mysensors/SensebenderGW/Enclosure/NRF24 NonPA enclosure print 2.jpg

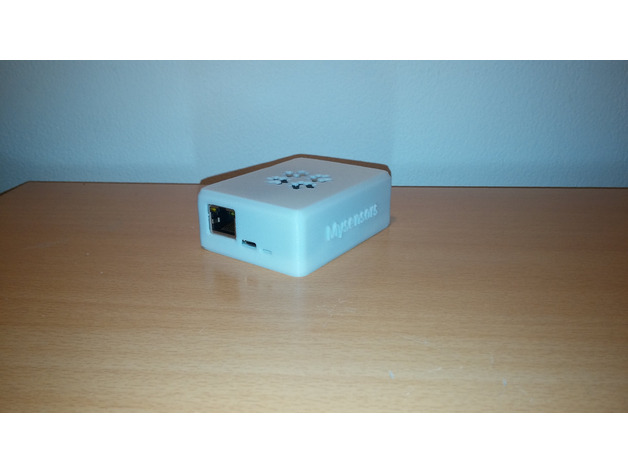
Enclosure/NRF24 NonPA enclosure print 2.jpg
