mysensors/SensebenderGW/Enclosure/NRF24 NonPA enclosure print 1.jpg

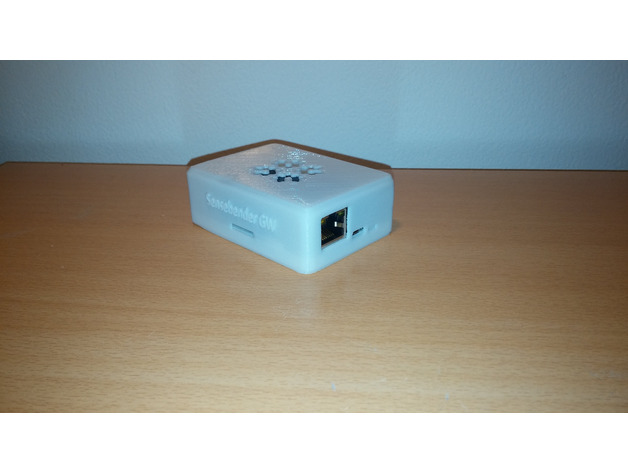
Enclosure/NRF24 NonPA enclosure print 1.jpg
