mysensors/SensebenderGW/Enclosure/3D preview rfm69 1.jpg

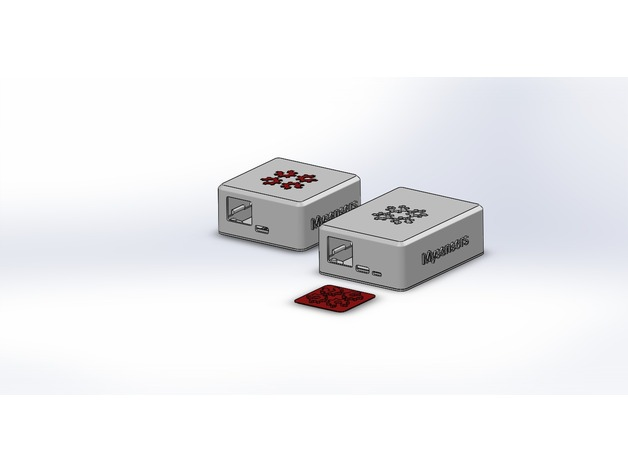
Enclosure/3D preview rfm69 1.jpg
