mysensors/SensebenderGW/Enclosure/3D preview rfm69 2.jpg

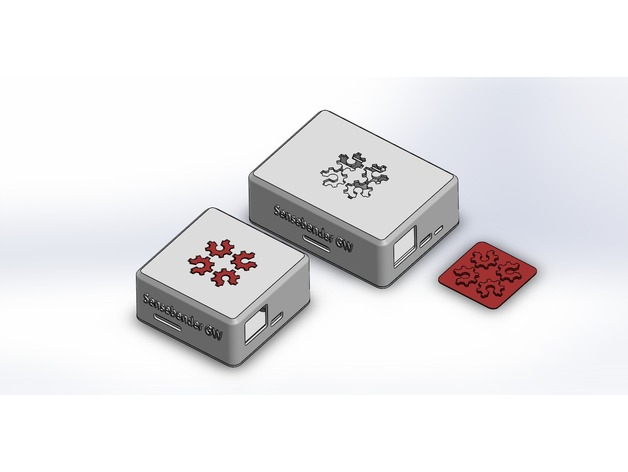
Enclosure/3D preview rfm69 2.jpg
