mysensors/SensebenderGW/Enclosure/NRF24 NonPA enclosure plate.jpg

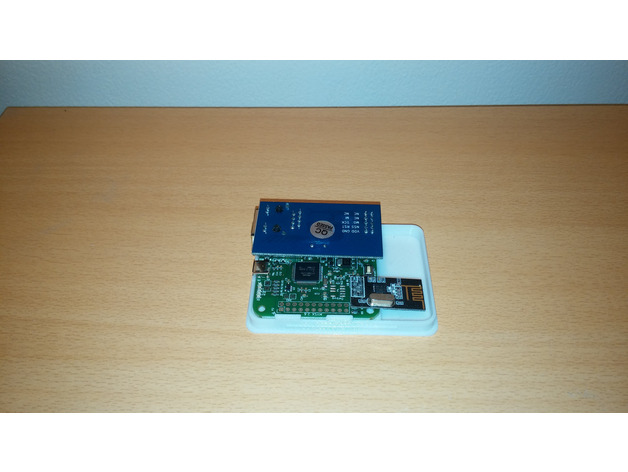
Enclosure/NRF24 NonPA enclosure plate.jpg
