mysensors/SensebenderGW/Enclosure/RFM69 enclosure plate.jpg

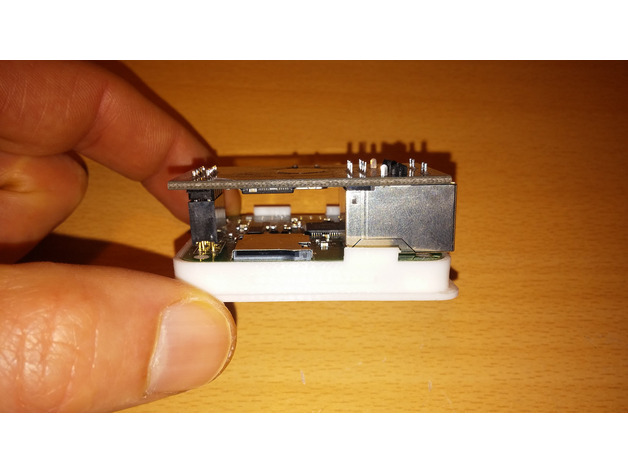
Enclosure/RFM69 enclosure plate.jpg
