mysensors/SensebenderGW/MysensorsGW.jpg

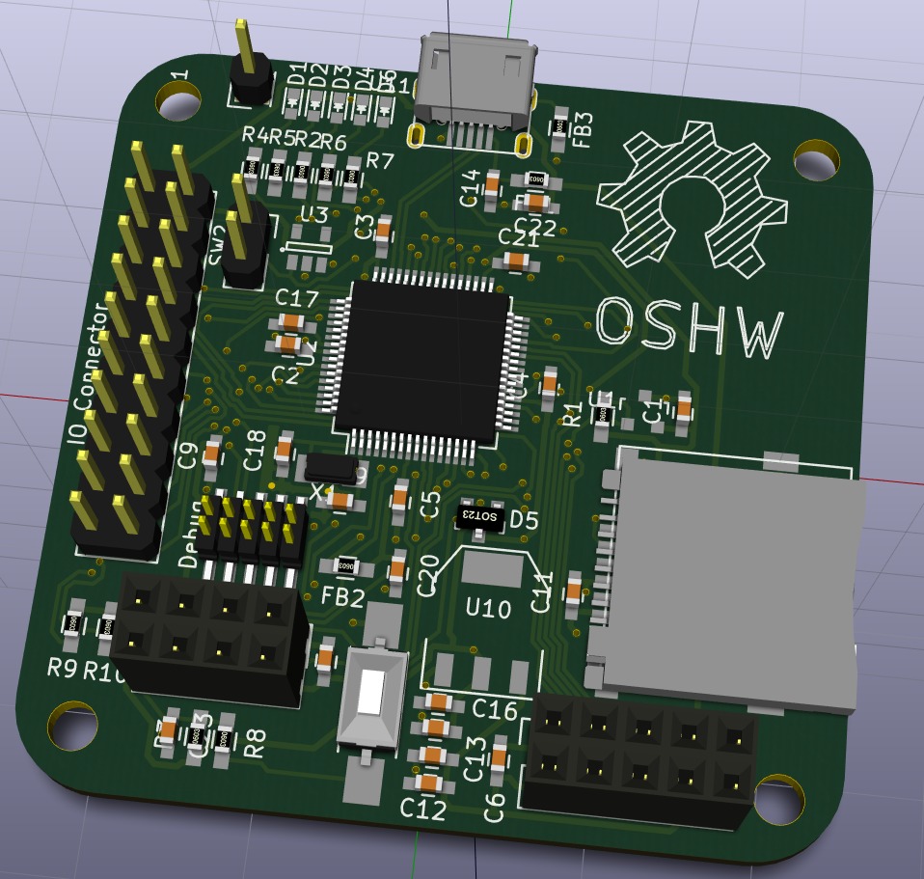
MysensorsGW.jpg
