mysensors/SensebenderGW/Enclosure/SBD_GW_LID_PA.STL

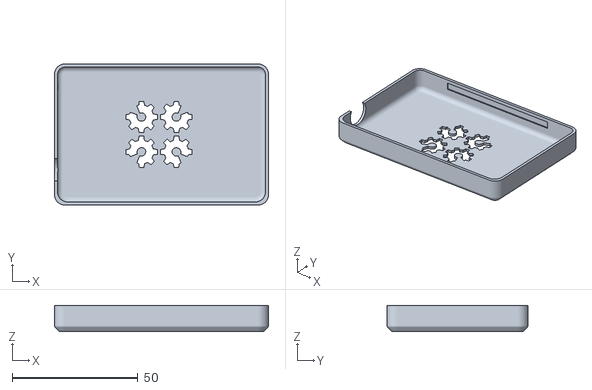
[picture p8: CAD file, 2017-03-17]
Enclosure/SBD_GW_LID_PA.STL
85.0 x 56.0 x 10.4
