mysensors/SensebenderGW/Enclosure/SBD_GW_BOTTOM_PA.STL

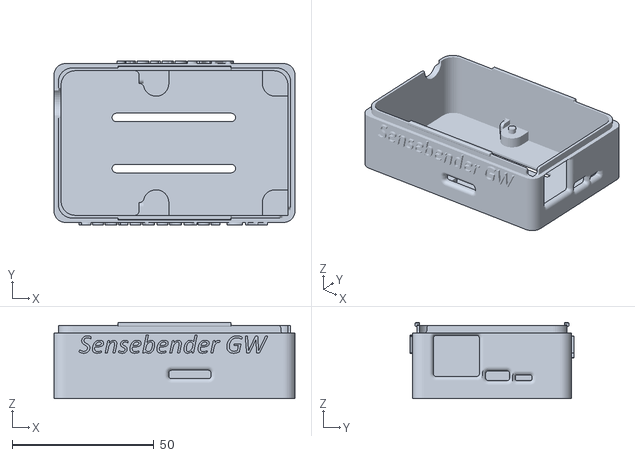
[picture p9: CAD file, 2017-03-17]
Enclosure/SBD_GW_BOTTOM_PA.STL
85.0 x 58.0 x 26.9
