mysensors/SensebenderGW/Enclosure/SBD_GW_BOTTOM_RFM69_only.STL

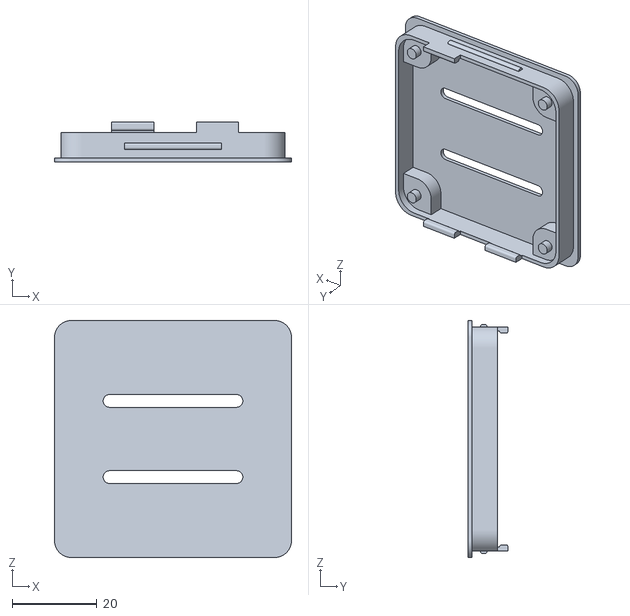
[picture p10: CAD file, 2017-02-04]
Enclosure/SBD_GW_BOTTOM_RFM69_only.STL
56.0 x 9.50 x 56.0
