mysensors/SensebenderGW/Enclosure/SBD_GW_LID_RFM69_only_with_leds_slot.STL

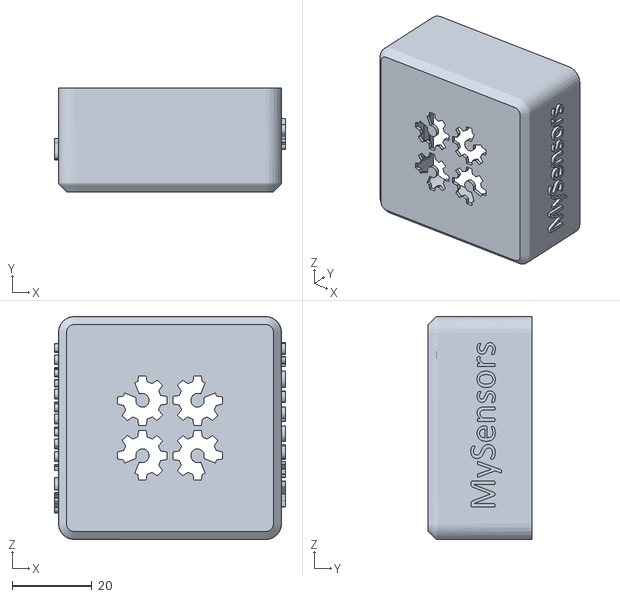
[picture p11: CAD file, 2017-02-04]
Enclosure/SBD_GW_LID_RFM69_only_with_leds_slot.STL
58.0 x 26.0 x 56.0
