mysensors/SensebenderGW/Enclosure/SBD_GW_LID_NRF24_NonPA_with_leds_slot.STL

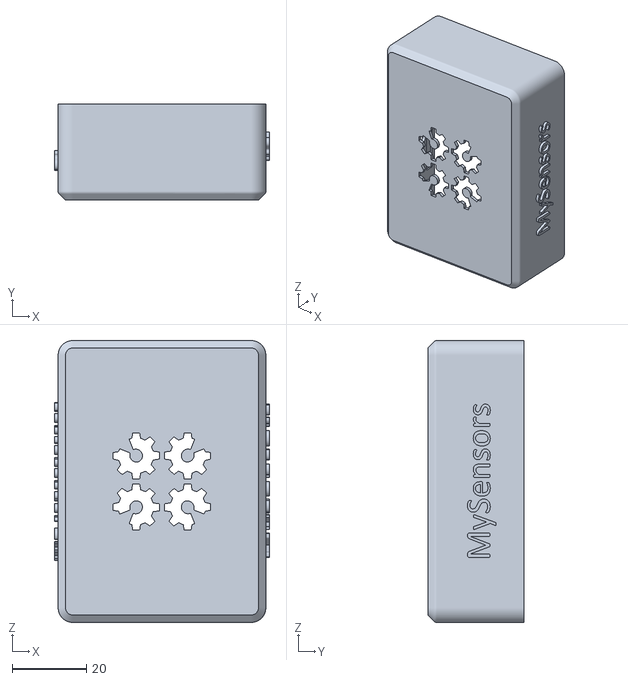
[picture p12: CAD file, 2017-02-04]
Enclosure/SBD_GW_LID_NRF24_NonPA_with_leds_slot.STL
58.0 x 26.0 x 76.0
