mysensors/SensebenderGW/Enclosure/SBD_GW_BOTTOM_NRF24_nonPA.STL

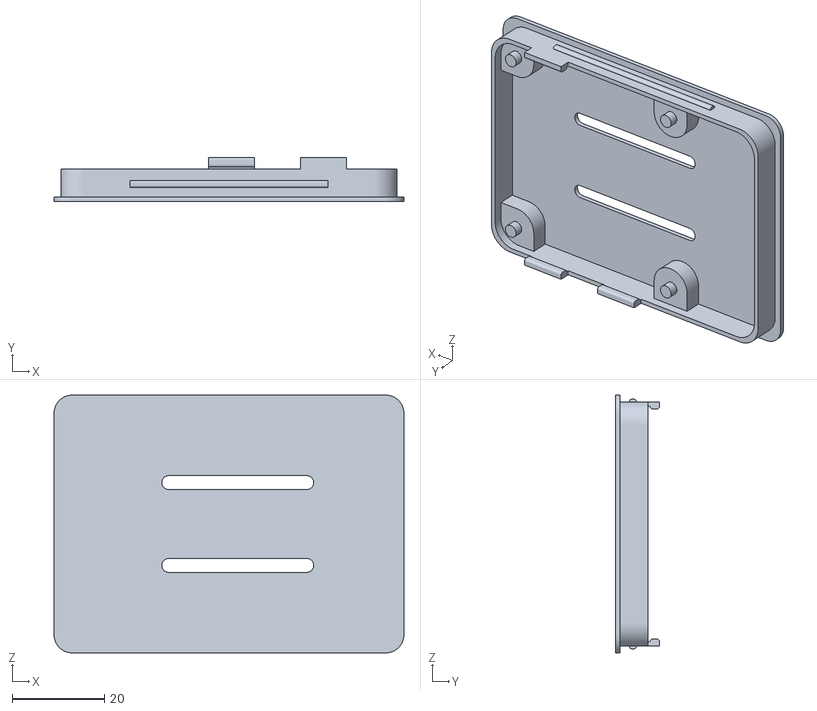
[picture p13: CAD file, 2017-02-04]
Enclosure/SBD_GW_BOTTOM_NRF24_nonPA.STL
76.0 x 9.50 x 56.0
