mysensors/SensebenderGW/Enclosure/Mini_logo_plate.STL

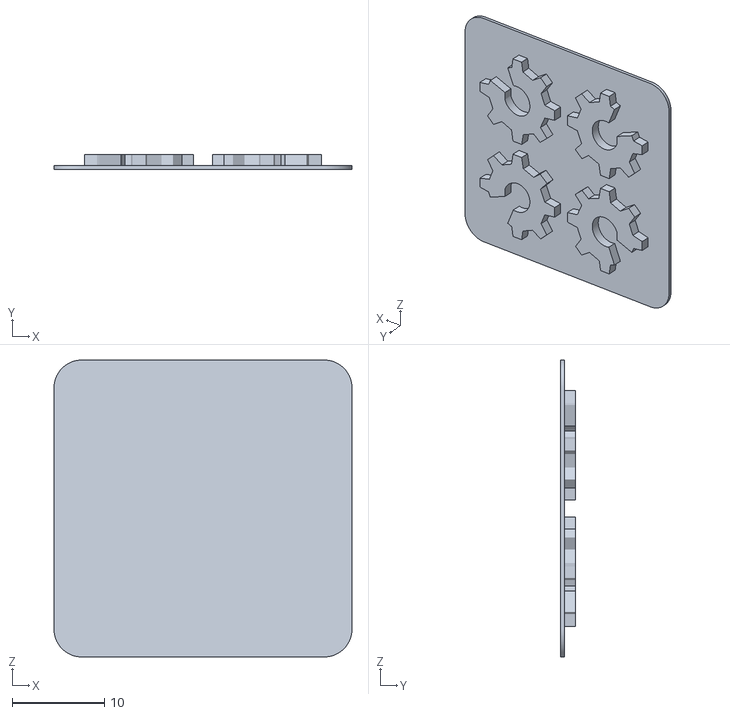
[picture p14: CAD file, 2017-02-04]
Enclosure/Mini_logo_plate.STL
32.3 x 1.60 x 32.2
