mysensors/SensebenderGW/(list of files, cad)

Other CAD files:
Enclosure/SBD_GW_BOTTOM_PA_NO_ETH.STL
Enclosure/SBD_GW_LID_RFM69_only_no_leds_slot.STL
Enclosure/SBD_GW_LID_NRF24_NonPA_no_leds_slot.STL
