mysensors/SensebenderGW/MysensorsGW.pdf

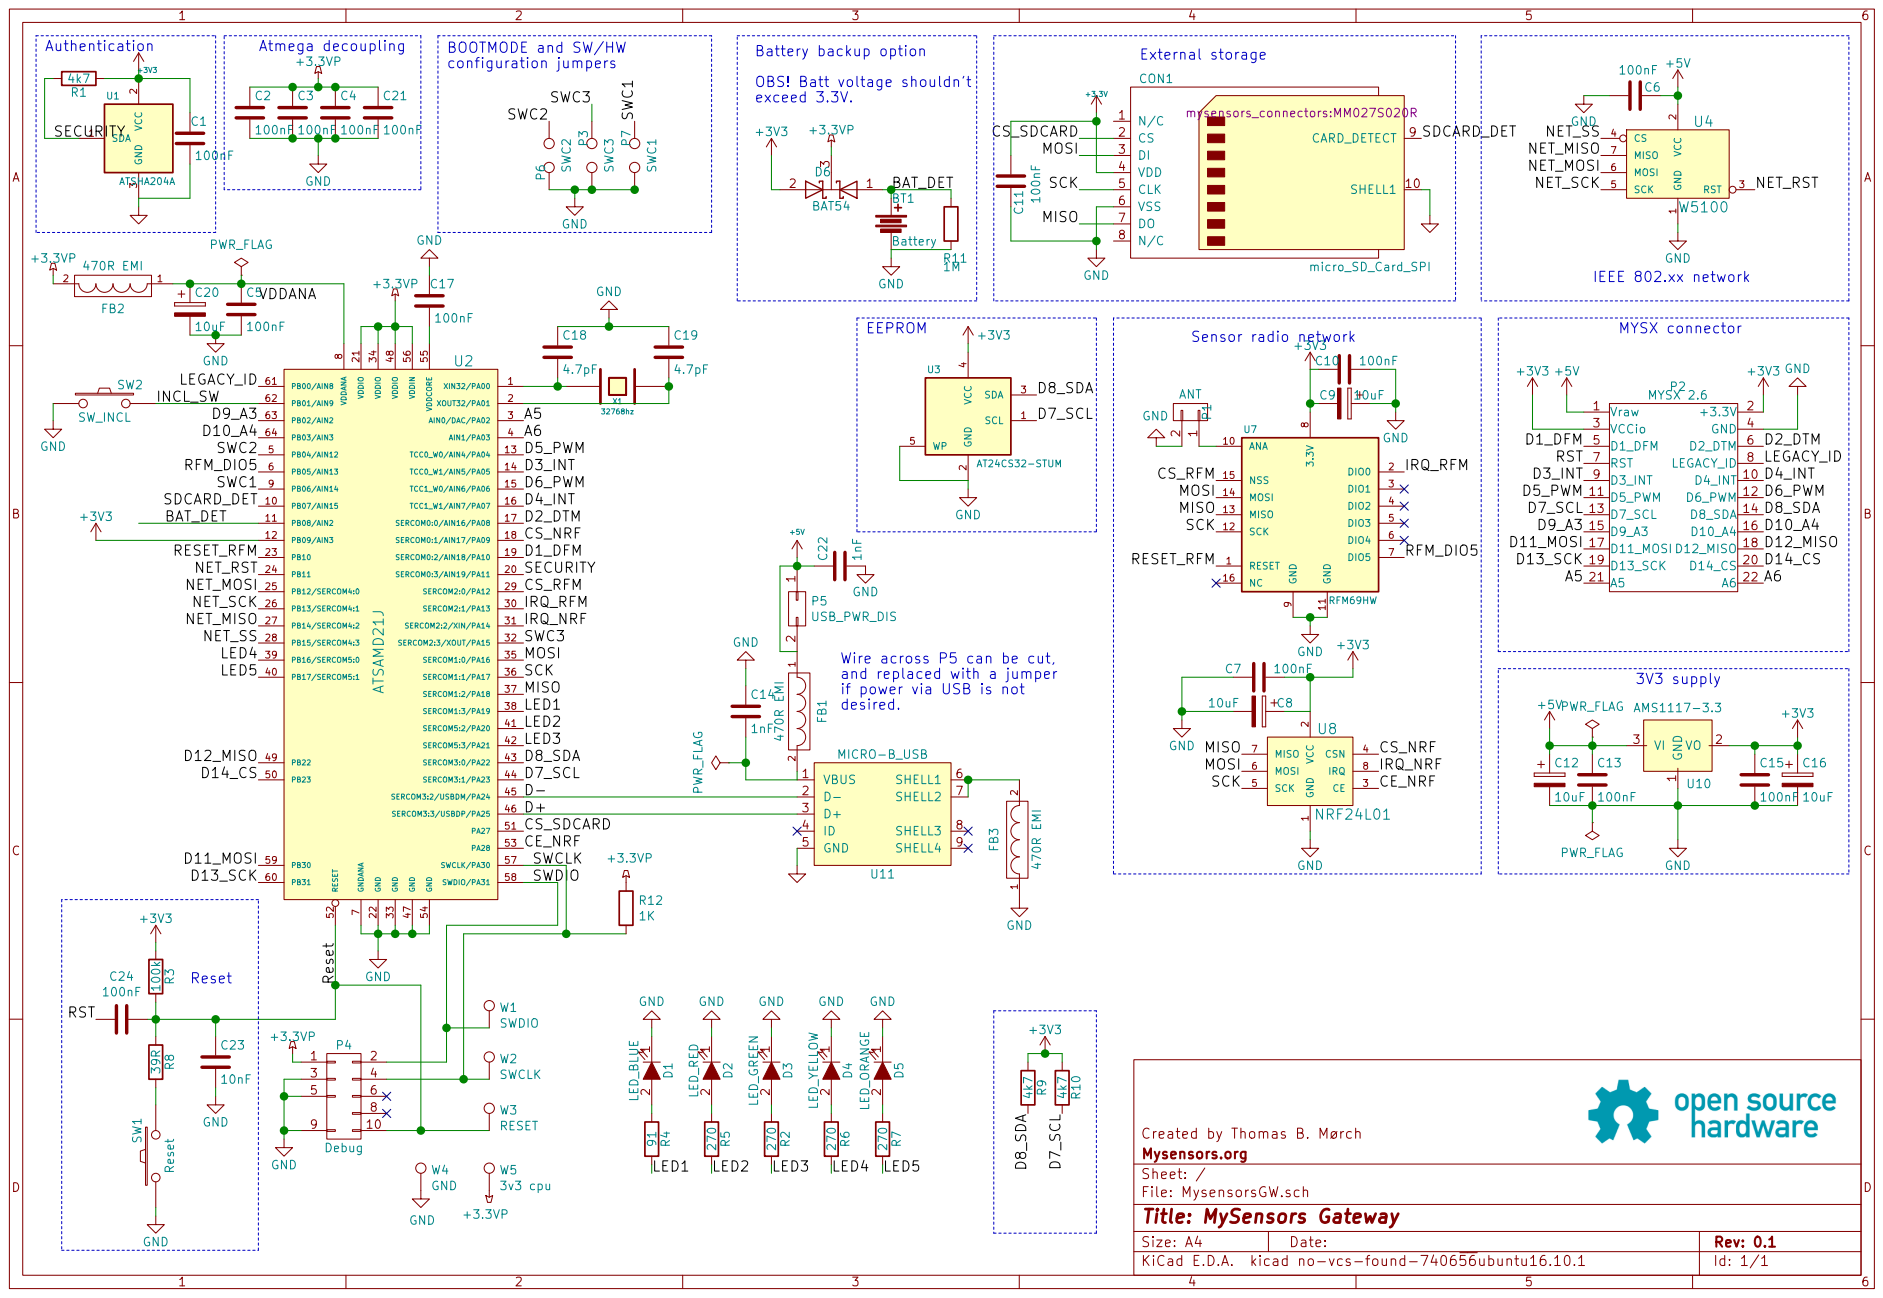
[picture p15: page 1]

3 D6 BAT54 BT1 Battery GND Battery backup option

2 RST 3 CS 4 SCK 5 MOSI 6 MISO 7 U4 W5100

IEEE 802.xx network MISO

9 ANA 10 GND 11 SCK 12 MISO 13 MOSI 14 NSS 15 NC 16 U7 RFM69HW D9_A3 D10_A4

1 2 P5 USB_PWR_DIS Wire across P5 can be cut,

and replaced with a jumper

2 CE 3 CSN 4 SCK 5 MOSI 6 MISO 7

CS_SDCARD

PB31 60 | SWDIO

File: MysensorsGW.sch Sheet: / Mysensors.org

Id: 1/1 Title: MySensors Gateway
