mysensors/SensebenderGW/(commit log)

2015-04-22 Beautified schematic a little
    [MysensorsGW.kicad_pcb, MysensorsGW.sch]
2015-04-25 Updated schematics
    [MysensorsGW.kicad_pcb, MysensorsGW.sch]
2015-05-11 Updated schematics, including w5100
    [MysensorsGW.kicad_pcb, MysensorsGW.sch, SensorRadio.sch]
2015-05-23 Added connectors for GPIO's, and other things..
    [MysensorsGW.kicad_pcb, MysensorsGW.sch, SensorRadio.sch]
2015-05-25 Cleaned up schematics, all components on one sheet of paper now
    [MysensorsGW.kicad_pcb, MysensorsGW.sch, SensorRadio.sch]
2015-05-27 Shematics cleanup
    [MysensorsGW.kicad_pcb, MysensorsGW.sch]
2015-05-27 Updated readme file, and legends on schematics
    [MysensorsGW.sch]
2015-05-27 Added BOM (csv file)
    [MysensorsGW.csv, MysensorsGW.kicad_pcb]
2015-06-01 Moving things around
    [MysensorsGW.kicad_pcb, MysensorsGW.sch]
2015-06-06 Added MAX3002E to do level conversion between 5V and 3v3 domains
    [MysensorsGW.kicad_pcb, MysensorsGW.sch]
2015-06-08 Updated schematics, exchanged one MAX3002 to a MAX3378, which is better suited for I2C bus
    [MysensorsGW.kicad_pcb, MysensorsGW.sch]
2015-06-10 Updated mouser references on components
    [MysensorsGW.csv, MysensorsGW.kicad_pcb, MysensorsGW.sch]
2015-06-20 Added 2 WS2812B rgb leds for status indicators, and filtering components on USB connector
    [MysensorsGW.csv, MysensorsGW.kicad_pcb, MysensorsGW.sch]
2015-06-21 Changed LED's to two standard led's instead of RGB (too much trouble in correct timing on the 1 wire control bus)
    Changed IO connector to a 2x11, instead of 2x14, and removed a couple of signals (there simply isn't that much space for the larger IO connector)
    [MysensorsGW.kicad_pcb, MysensorsGW.sch]
2015-06-22 Updated schematics, corrected errors / warnings in ERC
    [MysensorsGW.kicad_pcb, MysensorsGW.sch]
2015-06-22 Updated project files, to follow mysensors kicad library standard
    [MysensorsGW.sch]
2015-06-23 Updated project to mysensors_kicad standard. (see https://github.com/mysensors-kicad/part_management for more information)
    [MysensorsGW.kicad_pcb, MysensorsGW.sch]
2015-06-25 updated schematics a bit, updated PCB with 3dmockups. Added OSHW logo to schematics
    [MysensorsGW.kicad_pcb, MysensorsGW.sch]
2015-07-07 Updated schematic, swapped A2 and A3
    [MysensorsGW.sch]
2015-07-08 updating board connector, and moving pins around for the level shifters
2015-07-10 Rearrangement of MYSX connector in progress
    [MysensorsGW.kicad_pcb, MysensorsGW.sch]
2015-07-13 Changed MCU to ATSAMD21 instead of atmega1284.
    Removed level converters and FTDI chip, as it's not needed (builtin USB in the D21)
    [MysensorsGW.kicad_pcb, MysensorsGW.sch]
2015-07-13 Updated components with mouser order no. and prepared "core functionality" on a D21E variant of the atsam MCU
    [MysensorsGW.kicad_pcb, MysensorsGW.sch]
2015-07-17 Finished most of the routing on the board
    [MysensorsGW.kicad_pcb, MysensorsGW.sch]
2015-07-18 Added pullup on I2C bus
    [MysensorsGW.kicad_pcb, MysensorsGW.sch]
2015-07-18 Added gerber files
    [MysensorsGW-B_Cu.gbr, MysensorsGW-Edge_Cuts.gbr, MysensorsGW-F_Cu.gbr, MysensorsGW-F_Fab.gbr, MysensorsGW-F_Mask.gbr, MysensorsGW-F_Paste.gbr, MysensorsGW-F_SilkS.gbr, MysensorsGW-Margin.gbr]
2015-07-18 Removed ws2812b library reference from the schematics
    [MysensorsGW.kicad_pcb, MysensorsGW.sch]
2015-07-18 Added connection for ESP8266 GPIO0 (so we can put it into FW download mode
    [MysensorsGW.kicad_pcb]
2015-07-19 Added connection from GPIO2 on ESP module to port on ATSAM, added bottom layer solder mask
    [MysensorsGW-B_Cu.gbr, MysensorsGW-B_Mask.gbr, MysensorsGW-B_SilkS.gbr, MysensorsGW-Edge_Cuts.gbr, MysensorsGW-F_Cu.gbr, MysensorsGW-F_Fab.gbr, MysensorsGW-F_Mask.gbr, MysensorsGW-F_Paste.gbr]
2015-07-21 Removed FETs on outputs for LED, as it should be enough with 5mA for the LED.. (and max current is 7mA per IO pin)
    [MysensorsGW-B_Cu.gbr, MysensorsGW-B_Mask.gbr, MysensorsGW-B_SilkS.gbr, MysensorsGW-Edge_Cuts.gbr, MysensorsGW-F_Cu.gbr, MysensorsGW-F_Fab.gbr, MysensorsGW-F_Mask.gbr, MysensorsGW-F_Paste.gbr]
2015-07-21 Updated with module corrections on RFM69HW, from @fallberg
    [MysensorsGW.kicad_pcb]
2015-07-21 Added extra status LED (LED4)
    [MysensorsGW-B_Cu.gbr, MysensorsGW-B_Mask.gbr, MysensorsGW-B_SilkS.gbr, MysensorsGW-Edge_Cuts.gbr, MysensorsGW-F_Cu.gbr, MysensorsGW-F_Fab.gbr, MysensorsGW-F_Mask.gbr, MysensorsGW-F_Paste.gbr]
2015-07-24 Added extra i2c eeprom, U3, as the ATSAMD21 doesn't have an internal eeprom.
    [MysensorsGW-B_Cu.gbr, MysensorsGW-B_Mask.gbr, MysensorsGW-B_SilkS.gbr, MysensorsGW-Edge_Cuts.gbr, MysensorsGW-F_Cu.gbr, MysensorsGW-F_Fab.gbr, MysensorsGW-F_Mask.gbr, MysensorsGW-F_Paste.gbr]
2015-07-24 Updated USB connector to use right symbol in the schematics, Also added EMI filter from shield of USB cable to GND
    [MysensorsGW-B_Cu.gbr, MysensorsGW-B_Mask.gbr, MysensorsGW-B_SilkS.gbr, MysensorsGW-Edge_Cuts.gbr, MysensorsGW-F_Cu.gbr, MysensorsGW-F_Fab.gbr, MysensorsGW-F_Mask.gbr, MysensorsGW-F_Paste.gbr]
2015-07-24 Updated IO connector symbol in schematic to use MYSX1.5 connector, instead of generic
    [MysensorsGW.kicad_pcb, MysensorsGW.sch]
2015-07-24 Cleaned up schematic, DRC is now without errors
    [MysensorsGW.sch]
2015-07-25 Added jtagice3 compatible cortex M debug port to bottom layer
    [MysensorsGW-B_Cu.gbr, MysensorsGW-B_Mask.gbr, MysensorsGW-B_SilkS.gbr, MysensorsGW-Edge_Cuts.gbr, MysensorsGW-F_Cu.gbr, MysensorsGW-F_Fab.gbr, MysensorsGW-F_Mask.gbr, MysensorsGW-F_Paste.gbr]
2015-07-25 Calculated values for xtal load caps, and found mouser partnumbers
    [MysensorsGW.sch]
2015-07-25 Moved component designators around on the silkscreen layers, + Added descriptive texts here and there on the silk screen
    [MysensorsGW-B_Cu.gbr, MysensorsGW-B_Mask.gbr, MysensorsGW-B_SilkS.gbr, MysensorsGW-Edge_Cuts.gbr, MysensorsGW-F_Cu.gbr, MysensorsGW-F_Fab.gbr, MysensorsGW-F_Mask.gbr, MysensorsGW-F_Paste.gbr]
2015-07-26 Updated various components with more correct 3d shapes. Updated footprints for reset switch, and crystal, to match the chosen components from mouser
    [MysensorsGW-B_Cu.gbr, MysensorsGW-B_Mask.gbr, MysensorsGW-B_SilkS.gbr, MysensorsGW-Edge_Cuts.gbr, MysensorsGW-F_Cu.gbr, MysensorsGW-F_Fab.gbr, MysensorsGW-F_Mask.gbr, MysensorsGW-F_Paste.gbr]
2015-07-27 small updates in layout around NRF module header
    [MysensorsGW-B_Cu.gbr, MysensorsGW-B_Mask.gbr, MysensorsGW-B_SilkS.gbr, MysensorsGW-Edge_Cuts.gbr, MysensorsGW-F_Cu.gbr, MysensorsGW-F_Fab.gbr, MysensorsGW-F_Mask.gbr, MysensorsGW-F_Paste.gbr]
2015-07-28 small adjustments to pcb, removed unnescesarry files from manufacturing dir, drill files merged to one prepared manufacturing output script for creating dirtypcb gerbers
    [MysensorsGW-B_Cu.gbr, MysensorsGW-B_Mask.gbr, MysensorsGW-B_SilkS.gbr, MysensorsGW-Edge_Cuts.gbr, MysensorsGW-F_Cu.gbr, MysensorsGW-F_Fab.gbr, MysensorsGW-F_Mask.gbr, MysensorsGW-F_Paste.gbr]
2015-07-29 Cleaned up the last couple of DRC on pcb, that can be fixed (the rest is known, and intentional)
    [MysensorsGW-B_Cu.gbr, MysensorsGW-B_Mask.gbr, MysensorsGW-B_SilkS.gbr, MysensorsGW-Edge_Cuts.gbr, MysensorsGW-F_Cu.gbr, MysensorsGW-F_Fab.gbr, MysensorsGW-F_Mask.gbr, MysensorsGW-F_Paste.gbr]
2015-07-29 Final touch up before ordering
    [MysensorsGW-B_Cu.gbr, MysensorsGW-B_Mask.gbr, MysensorsGW-B_SilkS.gbr, MysensorsGW-Edge_Cuts.gbr, MysensorsGW-F_Cu.gbr, MysensorsGW-F_Fab.gbr, MysensorsGW-F_Mask.gbr, MysensorsGW-F_Paste.gbr]
2015-07-29 Added OSHW logo to silkscreen, order send
    [MysensorsGW-B_Cu.gbr, MysensorsGW-B_Mask.gbr, MysensorsGW-B_SilkS.gbr, MysensorsGW-Edge_Cuts.gbr, MysensorsGW-F_Cu.gbr, MysensorsGW-F_Fab.gbr, MysensorsGW-F_Mask.gbr, MysensorsGW-F_Paste.gbr]
2015-08-28 Swapped GND/VCC on jtagice3 connector Fixes #1
    [MysensorsGW.kicad_pcb, MysensorsGW.sch]
2015-08-30 Swapped pins around on the SPI signals. Added a couple of extra jumpers / testpoints to the backside, can be used to select special SW modes. fixes #2
    [MysensorsGW.kicad_pcb, MysensorsGW.sch]
2015-08-30 Swapped MISO/MOSI signals on esp8266 (doubles as RX/TX signals when SERCOM unit is acting as UART)
    [MysensorsGW.kicad_pcb, MysensorsGW.sch]
2015-08-31 Cleanup of the PCB, moved component refs, and texts a bit around
    [MysensorsGW-B_Cu.gbr, MysensorsGW-B_Mask.gbr, MysensorsGW-B_SilkS.gbr, MysensorsGW-Edge_Cuts.gbr, MysensorsGW-F_Cu.gbr, MysensorsGW-F_Fab.gbr, MysensorsGW-F_Mask.gbr, MysensorsGW-F_Paste.gbr]
2015-08-31 Adjusted mounting hole positions
    [MysensorsGW-B_Cu.gbr, MysensorsGW-B_Mask.gbr, MysensorsGW-B_SilkS.gbr, MysensorsGW-Edge_Cuts.gbr, MysensorsGW-F_Cu.gbr, MysensorsGW-F_Fab.gbr, MysensorsGW-F_Mask.gbr, MysensorsGW-F_Paste.gbr]
2015-08-31 Added BOM file
    [MysensorsGW.csv]
2015-09-01 Corrected UART connections to MYSX connector
    [MysensorsGW-B_Cu.gbr, MysensorsGW-B_Mask.gbr, MysensorsGW-B_SilkS.gbr, MysensorsGW-Edge_Cuts.gbr, MysensorsGW-F_Cu.gbr, MysensorsGW-F_Fab.gbr, MysensorsGW-F_Mask.gbr, MysensorsGW-F_Paste.gbr]
2015-09-01 Corrected bug in layout files, discovered after upload to dirtypcbs
    [MysensorsGW-B_Cu.gbr, MysensorsGW-B_Mask.gbr, MysensorsGW-B_SilkS.gbr, MysensorsGW-Edge_Cuts.gbr, MysensorsGW-F_Cu.gbr, MysensorsGW-F_Fab.gbr, MysensorsGW-F_Mask.gbr, MysensorsGW-F_Paste.gbr]
2015-09-04 Bumped rev. 0.7, as new gerbers have been sent to dirtypcbs, and silkscreen has been updated slightly
    [MysensorsGW-B_Cu.gbr, MysensorsGW-B_Mask.gbr, MysensorsGW-B_SilkS.gbr, MysensorsGW-Edge_Cuts.gbr, MysensorsGW-F_Cu.gbr, MysensorsGW-F_Fab.gbr, MysensorsGW-F_Mask.gbr, MysensorsGW-F_Paste.gbr]
2015-12-12 fixes #5 and #6
    [MysensorsGW.kicad_pcb, MysensorsGW.sch]
2016-01-09 KiCAD generated 3d image
2016-01-28 Added SDCARD reader, removed ESP8266 socket, seperated supply to mcu with bat54
    [MysensorsGW.kicad_pcb, MysensorsGW.sch]
2016-01-30 Added battery, cleaned up schematics
    [MysensorsGW.kicad_pcb, MysensorsGW.sch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]
2016-01-30 Added extra LED, cleaned up PCB DRC warnings
    [MysensorsGW.kicad_pcb, MysensorsGW.sch]
2016-01-30 Added pinheader for an inclusion button
    [MysensorsGW.kicad_pcb, MysensorsGW.sch]
2016-02-15 Small cleanups to layout, generated new jpg and pdf files for the board
    [MysensorsGW.kicad_pcb, MysensorsGW.sch]
2016-02-27 Added pinheader for battery backup
    [MysensorsGW.kicad_pcb, MysensorsGW.sch]
2016-02-27 Changed reset button to model recomended by itead studio
    [MysensorsGW.kicad_pcb]
2016-02-27 Updated schematics pdf
2016-02-28 Added testpads for programming pins
    [MysensorsGW.kicad_pcb, MysensorsGW.sch]
2016-02-29 Minor touchup of pcb
    [MysensorsGW.kicad_pcb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]
2016-03-11 Smal adjustments to layout
    [MysensorsGW.kicad_pcb, MysensorsGW.sch]
2016-03-15 Updated BOM file
    [MysensorsGW.csv]
2016-03-16 Added jumper for removing USB power
    [MysensorsGW.kicad_pcb, MysensorsGW.sch]
2016-03-21 Widened supply tracks
    [MysensorsGW.kicad_pcb, MysensorsGW.sch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]
2016-03-24 Files got renamed in kicad.
    [MysensorsGW-B.Cu.gbr, MysensorsGW-B.Mask.gbr, MysensorsGW-B.SilkS.gbr, MysensorsGW-B_Cu.gbr, MysensorsGW-B_Mask.gbr, MysensorsGW-B_SilkS.gbr, MysensorsGW-Edge.Cuts.gbr, MysensorsGW-F.Cu.gbr]
2016-03-24 updated BOM file for openhardware.io
    [MysensorsGW.csv]
2016-05-11 Widened supply lines, and moved components adjacent to ethernet jack
    [MysensorsGW.kicad_pcb, MysensorsGW.sch]
2016-05-19 Minor pcb touchup, and component values for schematics
    [MysensorsGW-B.Cu.gbr, MysensorsGW-B.Mask.gbr, MysensorsGW-B.SilkS.gbr, MysensorsGW-Edge.Cuts.gbr, MysensorsGW-F.Cu.gbr, MysensorsGW-F.Fab.gbr, MysensorsGW-F.Mask.gbr, MysensorsGW-F.Paste.gbr]
2016-05-30 Updated xtal value to 32768Hz
    [MysensorsGW.sch]
2016-05-31 Added an extra 100nF to both radios
    [MysensorsGW.kicad_pcb, MysensorsGW.sch]
2016-05-31 Updated manufacturing files
    [MysensorsGW-B.Cu.gbr, MysensorsGW-B.Mask.gbr, MysensorsGW-B.SilkS.gbr, MysensorsGW-Edge.Cuts.gbr, MysensorsGW-F.Cu.gbr, MysensorsGW-F.Fab.gbr, MysensorsGW-F.Mask.gbr, MysensorsGW-F.Paste.gbr]
2016-06-07 Updated pcb to use 6mil clearance
    at same time tracks got narrowed down to 8mil,
    Added extra caps to radios (100nF)
    [MysensorsGW-B.Cu.gbr, MysensorsGW-B.Mask.gbr, MysensorsGW-B.SilkS.gbr, MysensorsGW-Edge.Cuts.gbr, MysensorsGW-F.Cu.gbr, MysensorsGW-F.Fab.gbr, MysensorsGW-F.Mask.gbr, MysensorsGW-F.Paste.gbr]
2016-07-04 Added RFM reset signal, and DIO5 for future use
    [MysensorsGW-B.Cu.gbr, MysensorsGW-B.Mask.gbr, MysensorsGW-B.SilkS.gbr, MysensorsGW-Edge.Cuts.gbr, MysensorsGW-F.Cu.gbr, MysensorsGW-F.Fab.gbr, MysensorsGW-F.Mask.gbr, MysensorsGW-F.Paste.gbr]
2016-07-04 Renamed testmode and bootmode to SWC2/3
    [MysensorsGW.kicad_pcb, MysensorsGW.sch]
2016-07-04 Updated BOM
    [MysensorsGW.xlsx]
2016-08-10 Added P4 reference to silkscreen
    [MysensorsGW.kicad_pcb]
2016-08-30 Added pulldown on battery detect
    [MysensorsGW-B.Cu.gbr, MysensorsGW-B.Mask.gbr, MysensorsGW-B.SilkS.gbr, MysensorsGW-Edge.Cuts.gbr, MysensorsGW-F.Cu.gbr, MysensorsGW-F.Fab.gbr, MysensorsGW-F.Mask.gbr, MysensorsGW-F.Paste.gbr]
2016-08-30 Added logo
    [MysensorsGW-B.Cu.gbr, MysensorsGW-B.Mask.gbr, MysensorsGW-B.SilkS.gbr, MysensorsGW-Edge.Cuts.gbr, MysensorsGW-F.Cu.gbr, MysensorsGW-F.Fab.gbr, MysensorsGW-F.Mask.gbr, MysensorsGW-F.Paste.gbr]
2016-08-30 Updated BOM files
    [MysensorsGW.csv, MysensorsGW.xlsx]
2016-09-08 Changed MysX to MYSX 2.6
    [MysensorsGW.kicad_pcb, MysensorsGW.sch]
2016-09-08 Updated readme to reflect MYSX 2.6
    [MysensorsGW.kicad_pcb]
2016-09-11 Corrected MYSx2.6 pin names
    [MysensorsGW-B.Cu.gbr, MysensorsGW-B.Mask.gbr, MysensorsGW-B.SilkS.gbr, MysensorsGW-Edge.Cuts.gbr, MysensorsGW-F.Cu.gbr, MysensorsGW-F.Fab.gbr, MysensorsGW-F.Mask.gbr, MysensorsGW-F.Paste.gbr]
2016-09-11 Changed IO Connector to MYSX 2.6
    [MysensorsGW-B.Cu.gbr, MysensorsGW-B.Mask.gbr, MysensorsGW-B.SilkS.gbr, MysensorsGW-Edge.Cuts.gbr, MysensorsGW-F.Cu.gbr, MysensorsGW-F.Fab.gbr, MysensorsGW-F.Mask.gbr, MysensorsGW-F.Paste.gbr]
2016-10-14 Moved antenna connector for rfm
    [MysensorsGW.kicad_pcb, MysensorsGW.sch]
2016-11-23 recreated gerberfiles
    [MysensorsGW-B.Cu.gbr, MysensorsGW-B.Mask.gbr, MysensorsGW-B.SilkS.gbr, MysensorsGW-Edge.Cuts.gbr, MysensorsGW-F.Cu.gbr, MysensorsGW-F.Fab.gbr, MysensorsGW-F.Mask.gbr, MysensorsGW-F.Paste.gbr]
2016-11-28 Modified silkscreen layer
    - Changed sizes of all component designators
    - Moved component designators, so they are not under
    any other components
    [MysensorsGW-B.Cu.gbr, MysensorsGW-B.Mask.gbr, MysensorsGW-B.SilkS.gbr, MysensorsGW-Edge.Cuts.gbr, MysensorsGW-F.Cu.gbr, MysensorsGW-F.Fab.gbr, MysensorsGW-F.Mask.gbr, MysensorsGW-F.Paste.gbr]
2016-11-29 Added R12 pullup on SWCLK pin
    [MysensorsGW-B.Cu.gbr, MysensorsGW-B.Mask.gbr, MysensorsGW-B.SilkS.gbr, MysensorsGW-Edge.Cuts.gbr, MysensorsGW-F.Cu.gbr, MysensorsGW-F.Fab.gbr, MysensorsGW-F.Mask.gbr, MysensorsGW-F.Paste.gbr]
2016-12-23 Enlarged clearance around antenna connector P1 (for rfm69)
    [MysensorsGW.kicad_pcb]
2016-12-23 Remade production gerbers
    [MysensorsGW-B.Cu.gbr, MysensorsGW-B.Mask.gbr, MysensorsGW-B.SilkS.gbr, MysensorsGW-Edge.Cuts.gbr, MysensorsGW-F.Cu.gbr, MysensorsGW-F.Fab.gbr, MysensorsGW-F.Mask.gbr, MysensorsGW-F.Paste.gbr]
2017-02-04 3D printed enclosure for MySensors Sensebender GW
    - RFM69 only version
    - NRF24 non PA and RFM69 version
    - Openhardware.io Logo plate
    Each version has two different variants (with or without led indication
    slot)
    [Mini_logo_plate.STL, SBD_GW_BOTTOM_NRF24_nonPA.STL, SBD_GW_BOTTOM_RFM69_only.STL, SBD_GW_LID_NRF24_NonPA_no_leds_slot.STL, SBD_GW_LID_NRF24_NonPA_with_leds_slot.STL, SBD_GW_LID_RFM69_only_no_leds_slot.STL, SBD_GW_LID_RFM69_only_with_leds_slot.STL]
2017-02-04 Beautified BOM for use on openhardware.io
    [MysensorsGW.csv]
2017-03-17 Add Enclosure for SenseBender GW NRF24 PA version
    - Top : SBD_GW_LID_PA.STL
    - 2 bottom version : SBD_GW_BOTTOM_PA.STL or SBD_GW_BOTTOM_PA_NO_ETH.STL
    if not using ethernet connector
    [SBD_GW_BOTTOM_PA.STL, SBD_GW_BOTTOM_PA_NO_ETH.STL, SBD_GW_LID_PA.STL]
